ENACRobotique/2021_Robot_A_V2/elec/pcb_robot_2021A/pcb_robot_2021A.kicad_pcb

## KiCad design elec/pcb_robot_2021A/pcb_robot_2021A.kicad_pcb (2021-04-26)

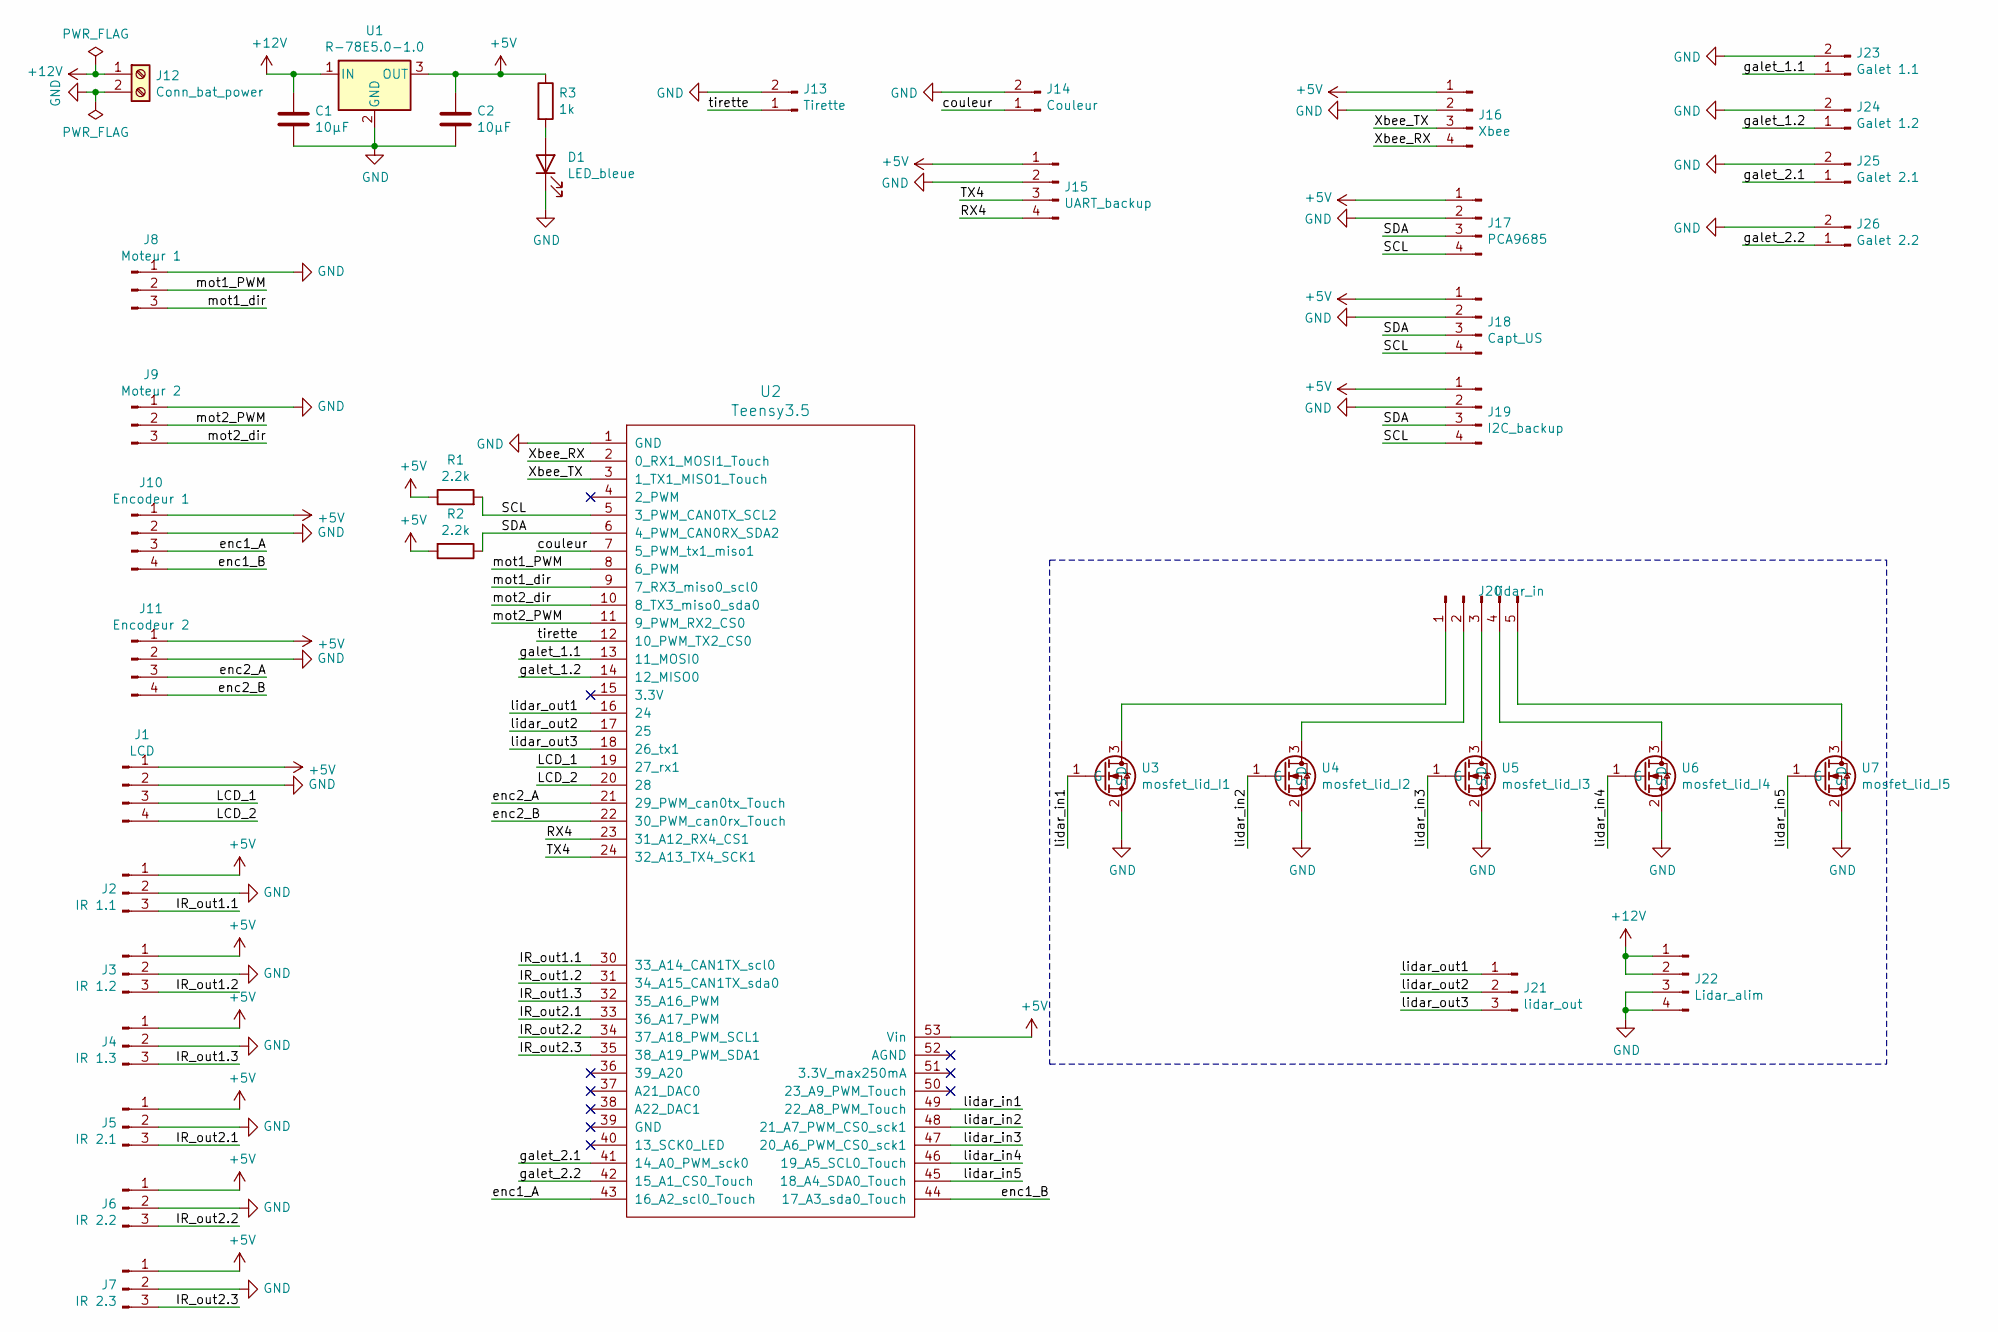
[picture p1: schematic pcb_robot_2021A.sch, Carte principale Robot 2021 A]

Parts:
C1, C2: 10µF; C_0805_2012Metric_Pad1.15x1.40mm_HandSolder
D1: LED_bleue; LED_0603_1608Metric_Pad1.05x0.95mm_HandSolder
J1: LCD; JST_XH_B4B-XH-A_1x04_P2.50mm_Vertical
J2: IR 1.1; JST_XH_B3B-XH-A_1x03_P2.50mm_Vertical
J3: IR 1.2; JST_XH_B3B-XH-A_1x03_P2.50mm_Vertical
J4: IR 1.3; JST_XH_B3B-XH-A_1x03_P2.50mm_Vertical
J5: IR 2.1; JST_XH_B3B-XH-A_1x03_P2.50mm_Vertical
J6: IR 2.2; JST_XH_B3B-XH-A_1x03_P2.50mm_Vertical
J7: IR 2.3; JST_XH_B3B-XH-A_1x03_P2.50mm_Vertical
J8: Moteur 1; JST_XH_B3B-XH-A_1x03_P2.50mm_Vertical
J9: Moteur 2; JST_XH_B3B-XH-A_1x03_P2.50mm_Vertical
J10: Encodeur 1; JST_XH_B4B-XH-A_1x04_P2.50mm_Vertical
J11: Encodeur 2; JST_XH_B4B-XH-A_1x04_P2.50mm_Vertical
J12: Conn_bat_power; TerminalBlock_bornier-2_P5.08mm
J13: Tirette; JST_XH_B2B-XH-A_1x02_P2.50mm_Vertical
J14: Couleur; JST_XH_B2B-XH-A_1x02_P2.50mm_Vertical
J15: UART_backup; JST_XH_B4B-XH-A_1x04_P2.50mm_Vertical
J16: Xbee; JST_XH_B4B-XH-A_1x04_P2.50mm_Vertical
J17: PCA9685; JST_XH_B4B-XH-A_1x04_P2.50mm_Vertical
J18: Capt_US; JST_XH_B4B-XH-A_1x04_P2.50mm_Vertical
J19: I2C_backup; JST_XH_B4B-XH-A_1x04_P2.50mm_Vertical
J20: lidar_in; PinHeader_1x05_P2.54mm_Vertical
J21: lidar_out; PinHeader_1x03_P2.54mm_Vertical
J22: Lidar_alim; JST_XH_B4B-XH-A_1x04_P2.50mm_Vertical
J23: Galet 1.1; JST_XH_B2B-XH-A_1x02_P2.50mm_Vertical
J24: Galet 1.2; JST_XH_B2B-XH-A_1x02_P2.50mm_Vertical
J25: Galet 2.1; JST_XH_B2B-XH-A_1x02_P2.50mm_Vertical
J26: Galet 2.2; JST_XH_B2B-XH-A_1x02_P2.50mm_Vertical
R1, R2: 2.2k; R_0805_2012Metric_Pad1.15x1.40mm_HandSolder
R3: 1k; R_0805_2012Metric_Pad1.15x1.40mm_HandSolder
U1: R-78E5.0-1.0; Converter_DCDC_RECOM_R-78E-0.5_THT
U2: Teensy3.5; Teensy35_36
U3: mosfet_lid_I1; SOT-23
U4: mosfet_lid_I2; SOT-23
U5: mosfet_lid_I3; SOT-23
U6: mosfet_lid_I4; SOT-23
U7: mosfet_lid_I5; SOT-23

Connections:
+5V: C2.1, J1.1, J2.1, J3.1, J4.1, J5.1, J6.1, J7.1, J10.1, J11.1, J15.1, J16.1, J17.1, J18.1, J19.1, R1.1, R2.2, R3.1, U1.3 (OUT), U2.53 (Vin)
+12V: C1.1, J12.1, J22.1, J22.2, U1.1 (IN)
/IR_out1.1: J2.3, U2.30 (33_A14_CAN1TX_scl0)
/IR_out1.2: J3.3, U2.31 (34_A15_CAN1TX_sda0)
/IR_out1.3: J4.3, U2.32 (35_A16_PWM)
/IR_out2.1: J5.3, U2.33 (36_A17_PWM)
/IR_out2.2: J6.3, U2.34 (37_A18_PWM_SCL1)
/IR_out2.3: J7.3, U2.35 (38_A19_PWM_SDA1)
/LCD_1: J1.3, U2.19 (27_rx1)
/LCD_2: J1.4, U2.20 (28)
/RX4: J15.4, U2.23 (31_A12_RX4_CS1)
/SCL: J17.4, J18.4, J19.4, R1.2, U2.5 (3_PWM_CAN0TX_SCL2)
/SDA: J17.3, J18.3, J19.3, R2.1, U2.6 (4_PWM_CAN0RX_SDA2)
/TX4: J15.3, U2.24 (32_A13_TX4_SCK1)
/Xbee_RX: J16.4, U2.2 (0_RX1_MOSI1_Touch)
/Xbee_TX: J16.3, U2.3 (1_TX1_MISO1_Touch)
/couleur: J14.1, U2.7 (5_PWM_tx1_miso1)
/enc1_A: J10.3, U2.43 (16_A2_scl0_Touch)
/enc1_B: J10.4, U2.44 (17_A3_sda0_Touch)
/enc2_A: J11.3, U2.21 (29_PWM_can0tx_Touch)
/enc2_B: J11.4, U2.22 (30_PWM_can0rx_Touch)
/galet_1.1: J23.1, U2.13 (11_MOSI0)
/galet_1.2: J24.1, U2.14 (12_MISO0)
/galet_2.1: J25.1, U2.41 (14_A0_PWM_sck0)
/galet_2.2: J26.1, U2.42 (15_A1_CS0_Touch)
/lidar_in1: U2.49 (22_A8_PWM_Touch), U3.1 (G)
/lidar_in2: U2.48 (21_A7_PWM_CS0_sck1), U4.1 (G)
/lidar_in3: U2.47 (20_A6_PWM_CS0_sck1), U5.1 (G)
/lidar_in4: U2.46 (19_A5_SCL0_Touch), U6.1 (G)
/lidar_in5: U2.45 (18_A4_SDA0_Touch), U7.1 (G)
/lidar_out1: J21.1, U2.16 (24)
/lidar_out2: J21.2, U2.17 (25)
/lidar_out3: J21.3, U2.18 (26_tx1)
/mot1_PWM: J8.2, U2.8 (6_PWM)
/mot1_dir: J8.3, U2.9 (7_RX3_miso0_scl0)
/mot2_PWM: J9.2, U2.11 (9_PWM_RX2_CS0)
/mot2_dir: J9.3, U2.10 (8_TX3_miso0_sda0)
/tirette: J13.1, U2.12 (10_PWM_TX2_CS0)
GND: C1.2, C2.2, D1.1 (K), J1.2, J2.2, J3.2, J4.2, J5.2, J6.2, J7.2, J8.1, J9.1, J10.2, J11.2, J12.2, J13.2, J14.2, J15.2, J16.2, J17.2, J18.2, J19.2, J22.3, J22.4, J23.2, J24.2, J25.2, J26.2, U1.2 (GND), U2.1 (GND), U3.2 (S), U4.2 (S), U5.2 (S), U6.2 (S), U7.2 (S)
unnamed: D1.2 (A), R3.2
unnamed: J20.1, U3.3 (D)
unnamed: J20.2, U4.3 (D)
unnamed: J20.3, U5.3 (D)
unnamed: J20.4, U6.3 (D)
unnamed: J20.5, U7.3 (D)

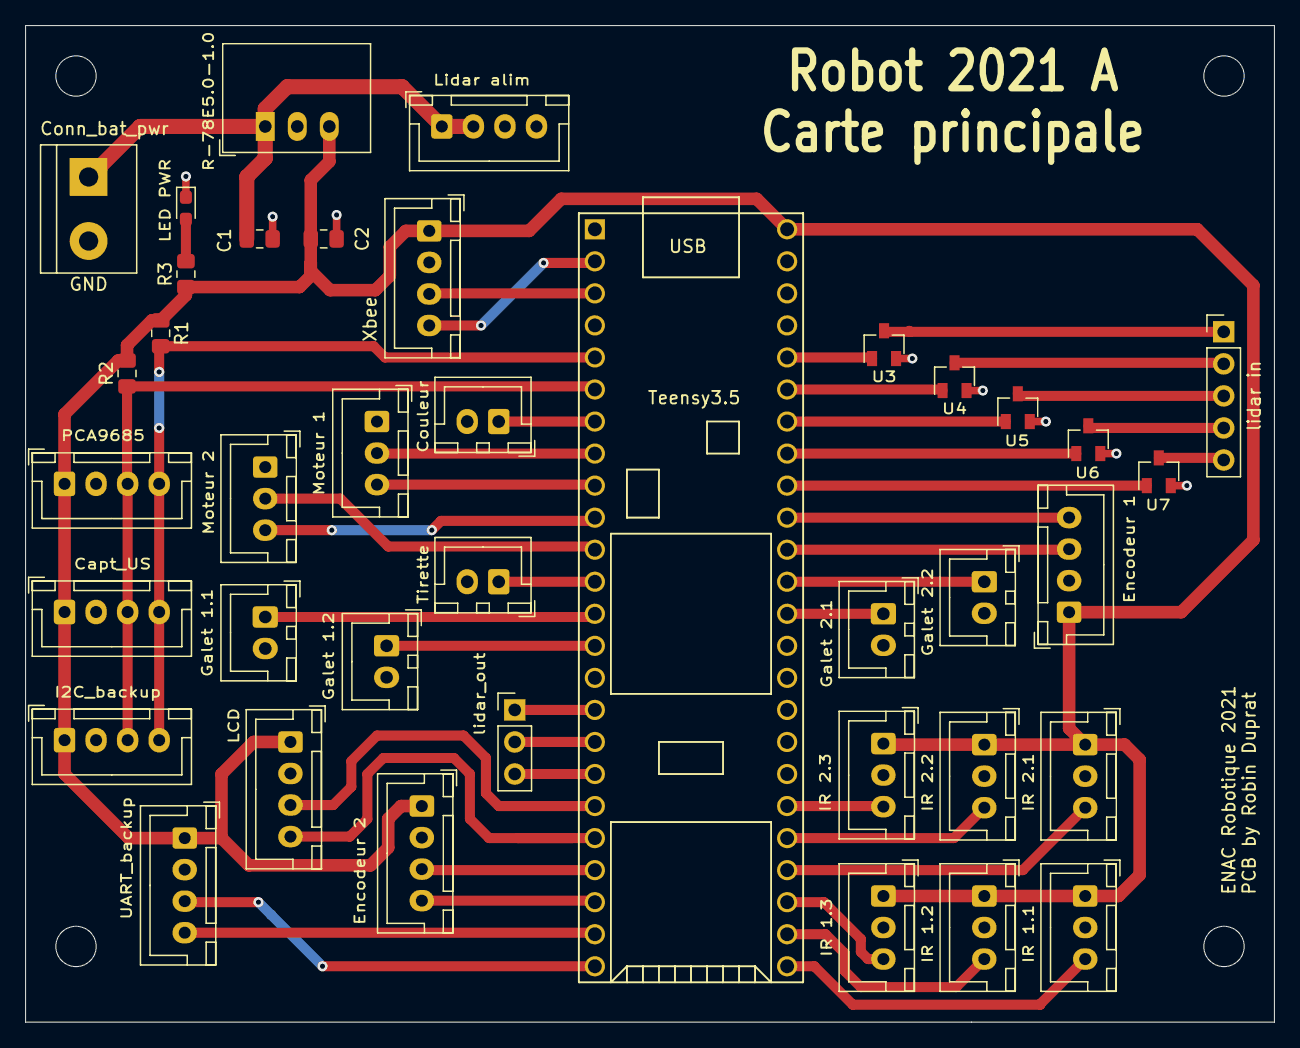
[picture p2: board pcb_robot_2021A.kicad_pcb from above]

Board: 2 copper layers, 99.0 x 79.0 mm, 39 parts (0 on the bottom side), 45 nets.
