ENACRobotique/2021_Robot_A_V2/elec/PCA9685/PCA9685.kicad_pcb

## KiCad design elec/PCA9685/PCA9685.kicad_pcb (2021-04-26)

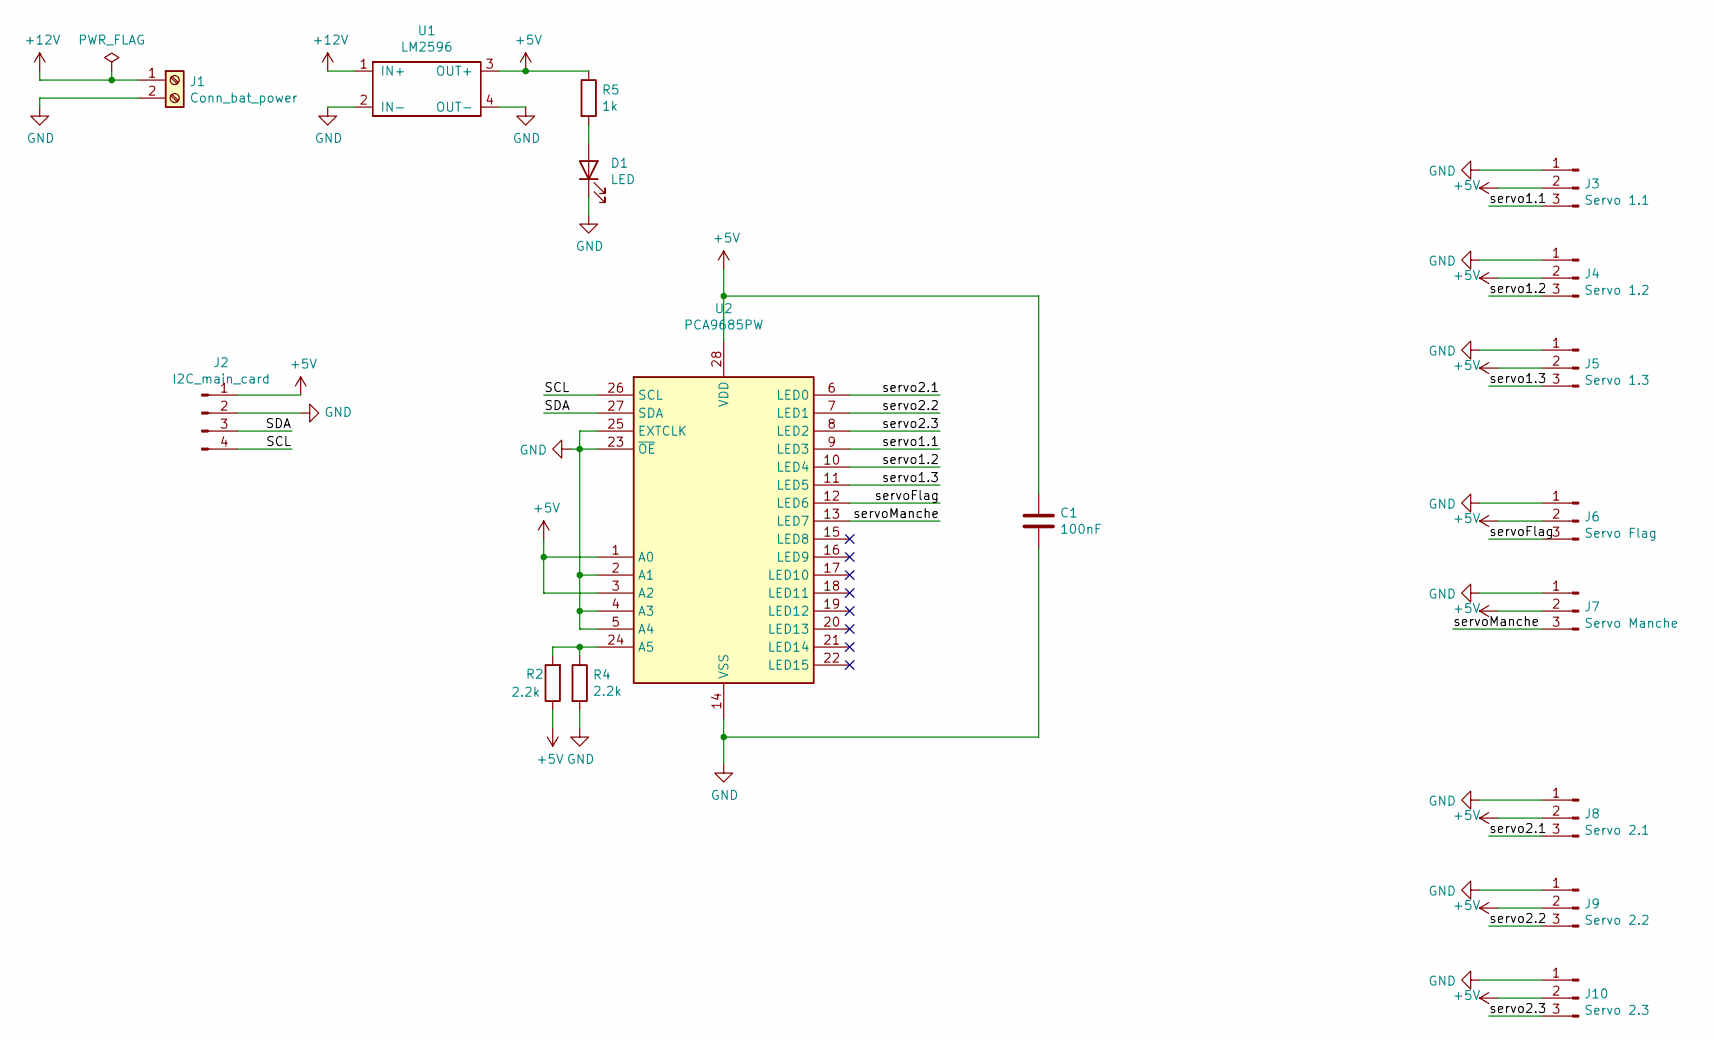
[picture p3: schematic PCA9685.sch, Robot 2021 A PCA9685]

Parts:
C1: 100nF; C_0805_2012Metric_Pad1.15x1.40mm_HandSolder
D1: LED; LED_0603_1608Metric_Pad1.05x0.95mm_HandSolder
J1: Conn_bat_power; TerminalBlock_bornier-2_P5.08mm
J2: I2C_main_card; JST_XH_B4B-XH-A_1x04_P2.50mm_Vertical
J3: Servo 1.1; PinHeader_1x03_P2.54mm_Vertical
J4: Servo 1.2; PinHeader_1x03_P2.54mm_Vertical
J5: Servo 1.3; PinHeader_1x03_P2.54mm_Vertical
J6: Servo Flag; PinHeader_1x03_P2.54mm_Vertical
J7: Servo Manche; PinHeader_1x03_P2.54mm_Vertical
J8: Servo 2.1; PinHeader_1x03_P2.54mm_Vertical
J9: Servo 2.2; PinHeader_1x03_P2.54mm_Vertical
J10: Servo 2.3; PinHeader_1x03_P2.54mm_Vertical
R2, R4: 2.2k; R_0805_2012Metric_Pad1.15x1.40mm_HandSolder
R5: 1k; R_0805_2012Metric_Pad1.15x1.40mm_HandSolder
U1: LM2596
U2: PCA9685PW; TSSOP-28_4.4x9.7mm_P0.65mm

Connections:
+5V: C1.1, J2.1, J3.2, J4.2, J5.2, J6.2, J7.2, J8.2, J9.2, J10.2, R2.1, R5.1, U1.3 (OUT+), U2.1 (A0), U2.3 (A2), U2.28 (VDD)
+12V: J1.1, U1.1 (IN+)
/SCL: J2.4, U2.26 (SCL)
/SDA: J2.3, U2.27 (SDA)
/servo1.1: J3.3, U2.9 (LED3)
/servo1.2: J4.3, U2.10 (LED4)
/servo1.3: J5.3, U2.11 (LED5)
/servo2.1: J8.3, U2.6 (LED0)
/servo2.2: J9.3, U2.7 (LED1)
/servo2.3: J10.3, U2.8 (LED2)
/servoFlag: J6.3, U2.12 (LED6)
/servoManche: J7.3, U2.13 (LED7)
GND: C1.2, D1.1 (K), J1.2, J2.2, J3.1, J4.1, J5.1, J6.1, J7.1, J8.1, J9.1, J10.1, R4.2, U1.2 (IN-), U1.4 (OUT-), U2.2 (A1), U2.4 (A3), U2.5 (A4), U2.14 (VSS), U2.23 (~OE), U2.25 (EXTCLK)
unnamed: D1.2 (A), R5.2
unnamed: R2.2, R4.1, U2.24 (A5)

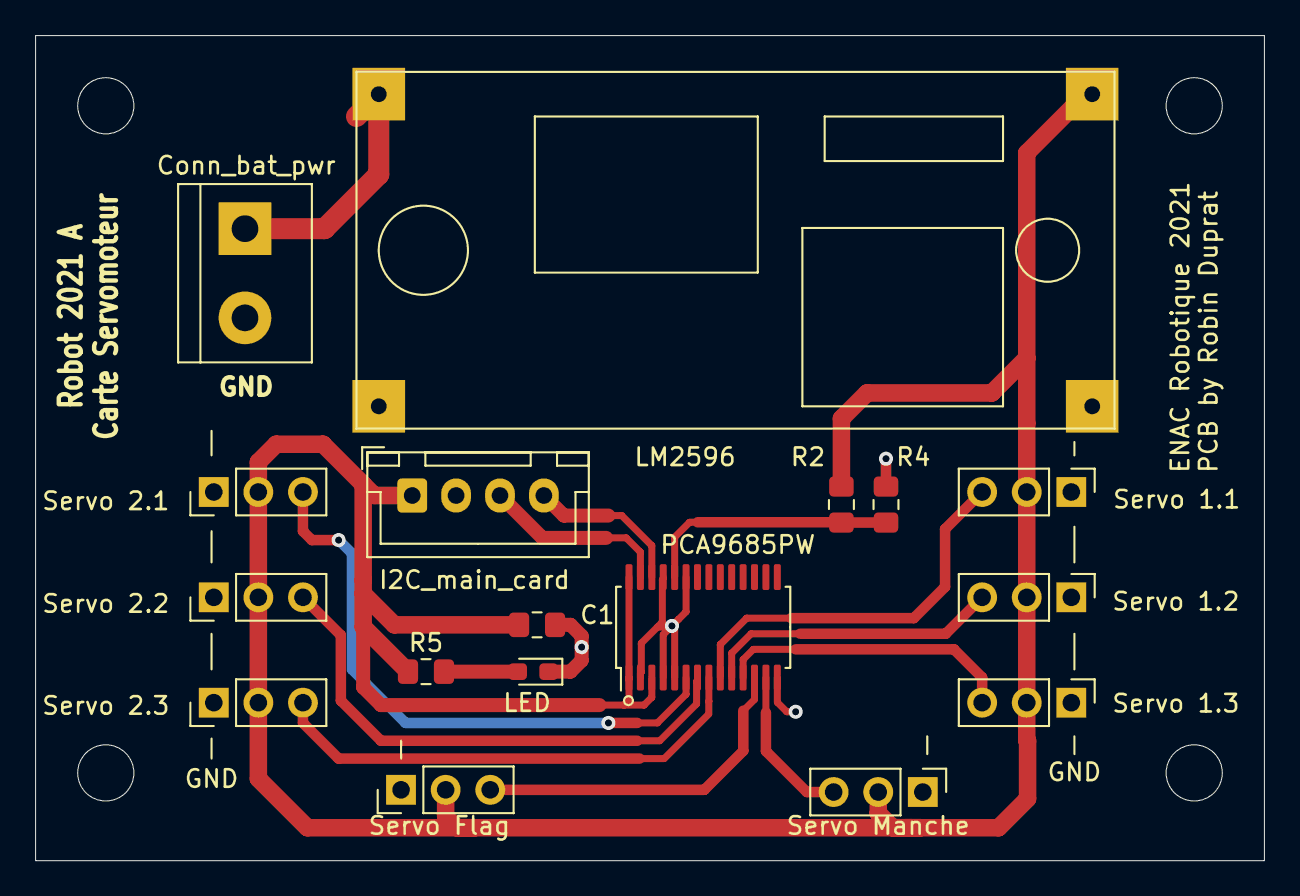
[picture p4: board PCA9685.kicad_pcb from above]

Board: 2 copper layers, 70.0 x 47.0 mm, 17 parts (0 on the bottom side), 15 nets.
