ENACRobotique/2021_Robot_A_V2/src/controlServo.cpp

#include "controlServo.h"
#include "Arduino.h"
#include "PWMServo.h"
#include "params.h"

ControlServo::ControlServo(){
}

ControlServo::~ControlServo(){
}

void ControlServo::defInitAngle(int angle){
    init_angle = angle;
}

void ControlServo::init(int ServoPIN){
    servo.attach(ServoPIN);
    servo.write(init_angle);
    delay(15);
}

void ControlServo::moveServo(int angle){
    servo.write(angle);
    delay(15);
}

void ControlServo::resetPos(){
    servo.write(init_angle);
    delay(15);
}

int ControlServo::returnPos(){
    return(servo.read());
}
