ENACRobotique/2021_Robot_A_V2/src/navigator.cpp

/*
 * Trajectory.cpp
 *
 * Created on : 8 avril 2018
 * Author : Maxime
 */

#include "navigator.h"

#include "params.h"
#include "odometry.h"
#include "motorControl.h"
#include "math.h"

Navigator navigator = Navigator();

Navigator::Navigator(){
	turn_done = false;
	displacement_done = false;
	trajectory_done = false;
	x_target = 0;
	y_target = 0;
	theta_target = 0;
	move_type = TURN;
	move_state = STOPPED;

	pinMode(IR_sel, INPUT);
	compt_rot=1;
}

void Navigator::move_to(float x, float y){
	x_target = x;
	y_target = y;
	move_type = DISPLACEMENT;
	move_state = INITIAL_TURN;
	trajectory_done = false;
	Serial.print("moving_to : ");
	Serial.print(x_target);
	Serial.print("\t");
	Serial.println(y_target);
}

void Navigator::step_forward(float d){
	move_to(d*cos(Odometry::get_pos_theta()) + Odometry::get_pos_x(),d*sin(Odometry::get_pos_theta()) + Odometry::get_pos_y());
	move_state=CRUISE;
	move_type = CAP;
}

void Navigator::step_backward(float d){
	move_to(-d*cos(Odometry::get_pos_theta()) + Odometry::get_pos_x(),-d*sin(Odometry::get_pos_theta()) + Odometry::get_pos_y());
	move_state=CRUISE;
}


void Navigator::turn_to(float theta){ // En degrés
	theta_target = center_radian(PI*theta/180);

	/*Serial.print("Angle: ");
	Serial.println(Odometry::get_pos_theta());
	Serial.print("moving_to : ");
	Serial.print(theta_target);
	Serial.print(" ( <  ");
	Serial.println(theta);*/

	move_type = TURN;
	move_state = INITIAL_TURN;
	trajectory_done = false;
}

void Navigator::adjust_rot(float delta_theta){ // En degrés
	theta_target = center_radian(Odometry::get_pos_theta()+PI*(delta_theta)/180);

	/*Serial.print("Angle: ");
	Serial.println(Odometry::get_pos_theta());
	Serial.print("moving_to : ");
	Serial.print(theta_target);
	Serial.print(" ( <  ");
	Serial.println(theta);*/

	move_type = CAP;
	move_state = INITIAL_TURN;
	trajectory_done = false;
}



void Navigator::throw_to(float x, float y, float theta){
	x_target = x;
	y_target = y;
	theta_target = theta;
	move_type = THROW;
	move_state = CRUISE;
	trajectory_done = false;
	/*Serial.print("throwing_to : ");
	Serial.print(x_target);
	Serial.print("\t");
	Serial.println(y_target);*/
}

float Navigator::compute_cons_speed()
{
	float speed_cons, dist_fore, t_stop, dist_objective;
	int sgn,MAX_ACCEL,MAX_SPEED;

	if(move_type == CAP && false){
		MAX_ACCEL = ACCEL_MAX_CAP;
		MAX_SPEED = SPEED_MAX_CAP;
	}
	else{
		MAX_ACCEL = ACCEL_MAX/2;
		MAX_SPEED = SPEED_MAX_CRUISE/3;
	}
	sgn = scalaire(cos(Odometry::get_pos_theta()),sin(Odometry::get_pos_theta()),x_target - Odometry::get_pos_x(),y_target - Odometry::get_pos_y());

	/*Serial.print("Sens d'avancée:");
	Serial.print("\t");
	Serial.println(sgn);*/

	//Test de décélération (on suppose l'accélération minimale et on intègre deux fois)
	t_stop = Odometry::get_speed()/MAX_ACCEL;
	dist_fore = (Odometry::get_speed()*t_stop-1/2*MAX_ACCEL*pow(t_stop,2));
	/*dist_fore = Odometry::get_speed()*t_stop;*/

	dist_objective = sqrt(pow(x_target - Odometry::get_pos_x(),2) + pow(y_target - Odometry::get_pos_y(),2));

	//Si le point estimé est suffisamment proche du point voulu, on décélére, sinon on accélére jusqu'à la vitesse maximale.
	if(abs( dist_fore - dist_objective ) < ADMITTED_POSITION_ERROR){
		speed_cons = sgn*max(0,-MAX_ACCEL*NAVIGATOR_PERIOD + abs(Odometry::get_speed()));
	}
	else{
		if(dist_fore - dist_objective > 0){
			speed_cons = sgn*max(0,abs(Odometry::get_speed()) - MAX_ACCEL*NAVIGATOR_PERIOD);
		}
		else{
			speed_cons = sgn*min(MAX_SPEED,abs(Odometry::get_speed()) + MAX_ACCEL*NAVIGATOR_PERIOD);
		}
	}
/*	Serial.print("Distances estimées");
	Serial.print("\t");
	Serial.print(dist_fore - dist_objective);
	Serial.print("\t");
	Serial.print(dist_objective);
	Serial.print("\tspeed= ");
	Serial.println(Odometry::get_speed());*/
	return speed_cons;
}


float Navigator::compute_cons_omega()
{	
	if(move_type == CAP && false){
		MAX_ACCEL_OMEGA = ACCEL_OMEGA_MAX_CAP;
		MAX_OMEGA = OMEGA_MAX_CAP;
	}
	else{
		MAX_ACCEL_OMEGA = ACCEL_OMEGA_MAX_CRUISE;
		MAX_OMEGA = OMEGA_MAX_CRUISE;
	}
	float omega_cons, angle_fore, alpha, t_rotation_stop;
	int sgn;

	if(move_type == DISPLACEMENT){
		alpha = Odometry::get_pos_theta() + center_axes(atan2((-y_target+Odometry::get_pos_y()),(-x_target+Odometry::get_pos_x())) - Odometry::get_pos_theta());
	}
	else{
		alpha = theta_target;
	}

	if (center_radian(alpha - Odometry::get_pos_theta()) > 0){
		sgn = 1;
	}
	else{
		sgn = -1;
	}
	t_rotation_stop = abs(Odometry::get_omega())/MAX_ACCEL_OMEGA;
	angle_fore = center_radian(Odometry::get_pos_theta() + sgn*(abs(Odometry::get_omega())*t_rotation_stop -1/2*MAX_ACCEL_OMEGA*pow(t_rotation_stop,2)));
	if(abs(center_radian(angle_fore - alpha)) < ADMITTED_ANGLE_ERROR){
		omega_cons = sgn*max(0,abs(Odometry::get_omega()) - NAVIGATOR_PERIOD*MAX_ACCEL_OMEGA);
	}
	else{
		if(sgn*(center_radian(alpha - angle_fore)) > 0){
			omega_cons = sgn*min(MAX_OMEGA, NAVIGATOR_PERIOD*MAX_ACCEL_OMEGA + abs(Odometry::get_omega()));
		}
		else{
			omega_cons = sgn*max(0,abs(Odometry::get_omega()) - NAVIGATOR_PERIOD*MAX_ACCEL_OMEGA);
		}
	}
	/*Serial.print("Consigne angle:");
	Serial.print(omega_cons);
	Serial.print("\t");
	Serial.print("Alpha:");
	Serial.print(alpha);
	Serial.print("\t");
	Serial.print("angle_fore:");
	Serial.println(angle_fore);*/

	return omega_cons;
}

void Navigator::update(){
	/*
	a_r = analogRead(IR_sel);
	v_r =VOLT_TO_DIST(a_r);
	Serial1.println(v_r);*/
	///*
	float omega_cons,speed_cons,alpha,distance;
	if(move_type == BRAKE){
		int sgn = scalaire(cos(Odometry::get_pos_theta()),sin(Odometry::get_pos_theta()),x_target - Odometry::get_pos_x(),y_target - Odometry::get_pos_y());
		speed_cons = sgn*max(0,abs(Odometry::get_speed()) - EMERGENCY_BRAKE*NAVIGATOR_PERIOD);
		if(abs(Odometry::get_speed()) < ADMITTED_SPEED_ERROR){
			move_state = STOPPED;
			speed_cons = 0;
		}
		MotorControl::set_cons(speed_cons,0);
	}
	else{
		switch(move_state){
		case INITIAL_TURN:
			if(move_type==DISPLACEMENT){
				alpha = Odometry::get_pos_theta() + center_axes(atan2((-y_target+Odometry::get_pos_y()),(-x_target+Odometry::get_pos_x())) - Odometry::get_pos_theta());
			}

			else{
				alpha = theta_target;
			}
			turn_done = ((abs(center_radian(Odometry::get_pos_theta() - alpha)) < ADMITTED_ANGLE_ERROR)&&(Odometry::get_omega() < ADMITTED_OMEGA_ERROR));
			a_r = analogRead(IR_sel);
			v_r =VOLT_TO_DIST(a_r);
			cup_detected = (dist_min < v_r ) && (v_r < dist_max);
			if (false) {
				Serial1.println(v_r);
			}
			if(turn_done){
				Serial1.println("turn done");
				MotorControl::set_cons(0,0);
				switch(move_type){
				case TURN:
					move_state = STOPPED;
					trajectory_done = true;
					break;
				case DISPLACEMENT:
					move_state = CRUISE;
					break;
				case THROW:
					//Do nothing
					break;
				case BRAKE:
					//Do nothing
					break;
				case CAP:
					if (cup_detected&&false) {
						Serial1.println("eco cup found");
						compt_rot=1;
						Navigator::step_forward(v_r*10+delta_step_forward);
						break;
					}
					else if (compt_rot>4) {
						Serial1.print("erreur tdb\n");
						trajectory_done=true;
						compt_rot=1;
						error_cap=true;
						break;
					}
					else {
						compt_rot++;
						
						Navigator::adjust_rot(pow(-1,compt_rot)*compt_rot*nominal_delta_rot);
						break;						
					}
				}				
			}
			else if (cup_detected) {
				//Navigator::adjust_rot(Odometry::get_pos_theta());
				//omega_cons = compute_cons_omega();
				//MotorControl::set_cons(0,omega_cons);
				Serial1.println("eco cup found");

				theta_target = center_radian(Odometry::get_pos_theta()+pow(-1,compt_rot)*atan2f(3.1,v_r));
				MotorControl::set_cons(0,0);
				Navigator::step_forward(v_r*10+delta_step_forward);
			}
			else {
				omega_cons = compute_cons_omega();
				MotorControl::set_cons(0,omega_cons);
			}
			break;
		case CRUISE:
			
			distance = sqrt(pow(x_target - Odometry::get_pos_x(),2) + pow(y_target - Odometry::get_pos_y(),2));
			
			displacement_done = ((distance<ADMITTED_POSITION_ERROR)&&(Odometry::get_speed() < ADMITTED_SPEED_ERROR*2));
			v_r=VOLT_TO_DIST(analogRead(IR_sel));	
			cup_detected = (dist_min < v_r ) && (v_r < dist_max);
			cup_ready = (((dist_opt-0.5)< v_r) && (v_r < (dist_opt+0.5)));
			if (move_type==CAP) {
				if (cup_ready) {
					MotorControl::set_cons(0,0);
					Navigator::step_forward(0.0);
					move_state=STOPPED;
					compt_rot=1;
					trajectory_done=true;
					error_cap = false;			
				}

				else if(displacement_done){
					MotorControl::set_cons(0,0);
					Navigator::adjust_rot(nominal_delta_rot);
					
				}
				else {
					speed_cons=compute_cons_speed();
					omega_cons = compute_cons_omega();
					MotorControl::set_cons(speed_cons,omega_cons);
				}
			}			
			
			else if(displacement_done){
				MotorControl::set_cons(0,0);
				move_state=STOPPED;
				trajectory_done = true;
				break;
			}			
			else{
				speed_cons=compute_cons_speed();
				omega_cons = compute_cons_omega();
				MotorControl::set_cons(speed_cons,omega_cons);
			}
			
			break;
		case STOPPED:
			//do nothing
			break;
		}
	}
	//*/
}

void Navigator::forceStop(){
	move_type = BRAKE;
}

bool Navigator::moveForward(){
	int dir = scalaire(cos(Odometry::get_pos_theta()),sin(Odometry::get_pos_theta()),x_target - Odometry::get_pos_x(),y_target - Odometry::get_pos_y());
	if(dir>0){
		return true;
	}
	else{
		return false;
	}
}


float Navigator::center_axes(float angle)
{
	/*Serial.print("center radian:");
		Serial.print("\t");
		Serial.print(angle);
		Serial.print("\t");*/
	if (abs(angle) > PI){
		if(angle<0){
			while(abs(angle)>PI){
				angle+=PI*2;
			}
		}
		else{
			while(abs(angle)>PI){
				angle-=2*PI;
			}
		}
	}
	if(abs(angle+PI) + ADMITTED_ANGLE_ERROR < abs(angle)){
		angle+=PI;
	}
	if(abs(angle-PI) + ADMITTED_ANGLE_ERROR< abs(angle)){
		angle-=PI;
	}
	/*Serial.println(angle);*/
	return angle;
}

float Navigator::center_radian(float angle)
{
	if (abs(angle) > PI){
		if(angle<0){
			while(abs(angle)>PI){
				angle+=PI*2;
			}
		}
		else{
			while(abs(angle)>PI){
				angle-=2*PI;
			}
		}
	}
	return angle;
}


int Navigator::scalaire(float x,float y,float x2,float y2){
	if(x*x2 + y*y2>0){
		return 1;
	}
	else{
		return -1;
	}
}

bool Navigator::isTrajectoryFinished(){
	return trajectory_done;
}

bool Navigator::caperror(){
	return error_cap;
}
