ENACRobotique/2021_Robot_A_V2/src/example.cpp

// #include <Arduino.h>
// #include "communication.h"

// void setup() {
//   Serial.begin(115200);
//   pinMode(LED_BUILTIN, OUTPUT);
//   while (!Serial);
  
// }

// void loop() {
//   send_odom_report(12.2, 34.2, 14.8);
//   delay(800);

//   //echo back received bytes, just as a test
//   while(Serial.available()) {
//     Serial.write(Serial.read());
//   }
  
//   digitalToggle(LED_BUILTIN);
// }
