ENACRobotique/2021_Robot_A_V2/(commit log)

2021-02-11 Ajout raspberryParser
2021-02-11 inclusion raspberryParser dans communication.cpp
2021-02-13 servo test and library controlServo
2021-02-13 Ajout test servo
2021-02-16 Initialisation elec
    [pcb_robot_2021A.kicad_pcb, pcb_robot_2021A.sch]
2021-02-20 Ajout moteur, tirette, couleur, début lidar et interrupteur galet
    [pcb_robot_2021A.sch]
2021-02-20 update lidar
    [pcb_robot_2021A.sch]
2021-02-21 Connectique lidar hokuyo
    [pcb_robot_2021A.sch]
2021-02-21 add PCA9685 conn on main card
    [pcb_robot_2021A.sch]
2021-02-21 update conn on teensy
    [pcb_robot_2021A.sch]
2021-02-21 schematic for PCA9685 (conn 8 servos)
    [PCA9685.kicad_pcb, PCA9685.sch, pcb_robot_2021A.sch]
2021-02-21 fin v1 PCA et main carte
    [PCA9685.sch, pcb_robot_2021A.sch]
2021-02-25 fin sch carte principale
    [PCA9685.sch, pcb_robot_2021A.sch]
2021-03-01 positionnement item sur le pcb de main card
    [pcb_robot_2021A.kicad_pcb]
2021-03-01 Fin première version routage main card
    [pcb_robot_2021A.kicad_pcb]
2021-03-01 empreintes carte PAC9685
    [PCA9685.sch, pcb_robot_2021A.sch]
2021-03-02 Routage carte PCA9685
    [PCA9685.sch]
2021-03-03 correction state reajustement et ajout etat test
    [kalman.cpp, navigator.cpp, navigator.h]
2021-03-03 Carte Principale V2 : Plus petite, correction de position de via et de connecteurs, bande plus large, ajout des trous de fixation
    [pcb_robot_2021A.kicad_pcb]
2021-03-03 Carte PCA9695 V2 : piste plus large, meilleur routage, texte au bon endroit et ajout des trous Carte Principale : Patch du texte, récupération d'une dizaine de mm sur un côté
    [PCA9685.kicad_pcb, pcb_robot_2021A.kicad_pcb]
2021-03-03 Carte Principale : 99mm de long !!!
    [PCA9685.kicad_pcb, pcb_robot_2021A.kicad_pcb]
2021-03-04 L'alignement des trous, c'est important
    [pcb_robot_2021A.kicad_pcb]
2021-03-04 Tentative de logo ENAC : echec Mise à jour visuelle, finission des cadres et plan de masse
    [PCA9685.kicad_pcb, pcb_robot_2021A.kicad_pcb]
2021-03-04 Patch footprint connecteurs servo sur carte PAC9685
    [PCA9685.kicad_pcb, PCA9685.sch, pcb_robot_2021A.kicad_pcb]
2021-03-04 Mise à jour espacement connecteur servo sur carte PCA9685
    [PCA9685.kicad_pcb]
2021-03-06 test de kalman données théoriques la prochaine fois
2021-03-06 String dans arduino.h, pas string.h
2021-03-09 Final push
    [PCA9685-B_Cu.gbr, PCA9685-B_Mask.gbr, PCA9685-B_Paste.gbr, PCA9685-B_SilkS.gbr, PCA9685-Edge_Cuts.gbr, PCA9685-F_Cu.gbr, PCA9685-F_Mask.gbr, PCA9685-F_Paste.gbr]
2021-03-11 ajout de l'état travel
